SamuelHuet/DevBoard_STM32/Generated_files/EMS/NC Drill/PCB_carte_design-RoundHoles.TXT

M48
;Layer_Color=9474304
;FILE_FORMAT=4:2
METRIC,LZ
;TYPE=PLATED
T1F00S00C0.20
T2F00S00C0.25
T4F00S00C0.80
T5F00S00C0.89
T6F00S00C0.90
T8F00S00C1.00
T10F00S00C1.60
T12F00S00C2.00
%
T01
X0114Y010664
Y010774
X01151
Y010664
X01496Y011761
Y011871
X015071
Y011761
X013865Y014495
Y014605
Y014715
X013755
X013645
Y014605
X013755
Y014495
X013645
X012127Y013117
Y013017
Y012917
Y012817
X012027
X011927
Y012917
Y013017
X012027
Y012917
Y013117
X011927
T02
X00805Y00805
X0084
X00875
X0091
X00945
X0098
X01015
X0105
X01085
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
