SamuelHuet/DevBoard_STM32/Generated_files/BOM.xls

Sheet: BOM Report
Bill of Materials |  |  | Bill of Materials for Project [Carte_design.PrjPcb] (No PCB Document Selected)
Source Data From: |  | Carte_design.PrjPcb
Project: |  | Carte_design.PrjPcb
Variant: |  | None
Creation Date: | 12/12/2019 | 12:43
Print Date: | 2019-12-29 | 16:32:05
Production Quantity: | 1
Currency | EUR
Footprint | Comment | LibRef | Designator | Description | Quantity | Supplier | Supplier Part Number | Supplier Unit Price | Supplier Order Qty | Supplier Subtotal | Manufacturer | Manufacturer Part Number | Manufacturer Lifecycle
603 | 0F | Capa | C66, C67 |  | 2 | Farnell | 2447743 | 0.0043 | 10 | 0.05 | Multicomp | MCWR06X000 PTL | Unknown
603 | 0R | Resistance | R50, R63, R65 |  | 3 | Farnell | 2447743 | 0.0043 | 10 | 0.05 | Multicomp | MCWR06X000 PTL | Unknown
603 | 0.1µF | Capa | C11, C12, C15, C57, C59, C63, C64, C1, C2, C3, C4, C8, C9, C17, C23, C25, C27, C29, C30, C31, C32, C33, C54 |  | 23 | Farnell | 3013451 | 0.028 | 25 | 0.70 | Samsung | CL10F104ZO8NNNC | Unknown
603 | 1µF | Capa | C26, C43, C45, C58, C60, C62, C65, C72 |  | 8 | Farnell | 3013384 | 0.0468 | 10 | 0.47 | Samsung | CL10A105KO8NNNC | Unknown
603 | 1k | Resistance | R34 |  | 1 | Farnell | 2694685 | 0.0041 | 10 | 0.05 | Multicomp | MCWR06X102 JTL | Unknown
603 | 1nF | Capa | C24, C46, C47 |  | 3 | Farnell | 2581039 | 0.0533 | 10 | 0.54 | Kemet | C0603C102K4RACTU | Unknown
603 | 1.5k | Resistance | R5, R6, R16, R36, R51, R57, R64 |  | 7 | Farnell | 2694727 | 0.0049 | 10 | 0.05 | Multicomp | MCWR06X152 JTL | Unknown
603 | 13.7k | Resistance | R54 |  | 1 | Farnell | 2670631 | 0.0537 | 10 | 0.54 | Walsin | WR06X1372FTL | Unknown
603 | 2.2µF | Capa | C13, C14, C34, C35, C36, C37 |  | 6 | Farnell | 3013392 | 0.112 | 10 | 1.12 | Samsung | CL10A225KO8NNNC | Unknown
603 | 4.7µF | Capa | C42, C44, C73 |  | 3 | Farnell | 2525098 | 0.0197 | 4 | 0.08 | TDK | C1608X5R1C475M080AC | Unknown
603 | 4.7k | Resistance | R8, R9, R17, R18 |  | 4 | Farnell | 2694880 | 0.0047 | 10 | 0.05 | Multicomp | MCWR06X472 JTL | Unknown
603 | 6.49k | Resistance | R39 |  | 1 | Farnell | 2447426 | 0.0047 | 10 | 0.05 | Multicomp | MCWR06X6491FTL | Unknown
603 | 10k | Resistance | R1, R2, R31, R47, R59 |  | 5 | Farnell | 2447230 | 0.0043 | 10 | 0.05 | Multicomp | MCWR06X1002FTL | Unknown
603 | 10nF | Capa | C7, C16, C21, C22, C28, C61 |  | 6 | Farnell | 2534021 | 0.0429 | 10 | 0.43 | Wurth | 885012206040 | Unknown
603 | 10R | Resistance | R32, R33, R35, R37, R38, R40, R41, R42, R43, R44, R45, R46 |  | 12 | Farnell | 2447233 | 0.0044 | 15 | 0.07 | Multicomp | MCWR06X10R0FTL | Unknown
603 | 15pF | Capa | C70, C71 |  | 2 | Farnell | 2812095 | 0.0507 | 10 | 0.51 | Wurth | 885012006018 | Unknown
603 | 22µF | Capa | C10, C49, C50, C51 |  | 4 | Farnell | 2426957 | 0.282 | 10 | 2.82 | Murata | GRM188R61A226ME15D | Unknown
603 | 22pF | Capa | C5, C6, C18, C19, C38, C39, C40, C41, C68, C69 |  | 10 | Farnell | 2533830 | 0.0507 | 15 | 0.77 | Wurth | 885012006019 | Unknown
603 | 22R | Resistance | R11, R12, R14, R15, R19, R20, R21, R22, R23, R24, R25, R26, R27, R28, R29, R52, R53 |  | 17 | Farnell | 2694060 | 0.0087 | 20 | 0.18 | Multicomp | MCWF06P22R0FTL | Unknown
603 | 100k | Resistance | R3, R4, R7, R49, R56, R58, R60, R61, R62, R66 |  | 10 | Farnell | 2333579 | 0.0105 | 15 | 0.16 | Bourns | CR0603-JW-104ELF | Unknown
603 | 100pF | Capa | C56 |  | 1 | Farnell | 2812335 | 0.0436 | 10 | 0.44 | Wurth | 885012206028 | Unknown
603 | 100R | Resistance | R10, R13, R30, R55 |  | 4 | Farnell | 2447227 | 0.0049 | 10 | 0.05 | Multicomp | MCWR06X1000FTL | Unknown
603 | 150nF | Capa | C55 |  | 1 | Farnell | 1759018 | 0.0533 | 10 | 0.54 | Multicomp | MC0603F154Z160CT | Unknown
603 | 220R | Resistance | R48 |  | 1 | Farnell | 2447298 | 0.0049 | 10 | 0.05 | Multicomp | MCWR06X2200FTL | Unknown
402 | 3.9nH | self2 | L3 |  | 1 | Digi-Key | 490-15282-1-ND | 0.14 | 1 | 0.14 | Murata | LQG15WZ3N9S02D | Unknown
603 | 10µF | Capa | C48, C52, C53 |  | 3 | Farnell | 2611923 | 0.335 | 10 | 3.35 | Murata | GRM188R61C106KAALD | Unknown
Capa_Radial_D4mm_H5.5mm, 0603 | 10µF | Capa_pola | C20 |  | 1 | Farnell | 2466357 | 0.237 | 1 | 0.24 | Wurth Electronics | 865090240001 | Volume Production
603 | 2nH | Self | L4 |  | 1 | Digi-Key | 490-5981-1-ND | 0.24 | 1 | 0.24 | Murata | BLM18GG471SN1D | Volume Production
4-UFBGA | BALF-NRG-02D3 | Balf | U11 |  | 1 | Digi-Key | 497-17591-1-ND | 0.28 | 2 | 0.56 | STMicroelectronics | BALF-NRG-02D3 | Unknown
Mini_USB_mixte | 10118193-0001LF | 10118193-0001LF | J1, J4 | CONN RCPT USB2.0 MICRO B SMD R/A | 2 | Digi-Key | 609-4616-1-ND | 0.39 | 2 | 0.78 | Amphenol ICC | 10118193-0001LF | Unknown
LEd_Pilou | RFN2LAM4STFTR | RFN2LAM4STFTR | D5, D6, D7 | RFN2LAM4STF IS THE HIGH RELIABIL | 3 | Mouser | 755-RFN2LAM4STFTR | 0.414 | 3 | 1.25 | Rohm | RFN2LAM4STFTR | Unknown
QFN50P300X300X65_HS-17M | PI5C3257ZHDEX | PI5C3257ZHDEX | U1 | Multiplexer/Demultiplexer Bus Switch 4-Channel 2: 1 16-Pin UQFN T/R | 1 | Digi-Key | PI5C3257ZHDEXDICT-ND | 0.53 | 1 | 0.53 | Diodes | PI5C3257ZHDEX | Unknown
PSON65P300X100_HS-9M | MCP1727-3302E/MF | LDO | U8 |  | 1 | Farnell | 1851978 | 0.756 | 1 | 0.76 | Microchip | MCP1727-3302E/MF | Volume Production
PSON65P300X100_HS-9M | MCP1727-ADJE/MF | LDO | U7 |  | 1 | Farnell | 1851979 | 0.756 | 1 | 0.76 | Microchip | MCP1727-ADJE/MF | Volume Production
 | 8MHz | Quartz_8MHz | Q1 |  | 1 | Farnell | 1611803 | 0.698 | 1 | 0.70 | Abracon | ABMM2-8.000MHZ-E2-T | Volume Production
Quartz_prog, Quartz_Micro_HF | 8MHz | Quartz_micro_HF | Q4 |  | 1 | Farnell | 2854010 | 0.6 | 1 | 0.60 | Multicomp | MCSJK-7I-8.00-10-10-60-B-10 | Unknown
QFN50P400X400X90_HS-25M | KSZ8081RNACA | KSZ8081RNACA | U4 | IC TXRX ETHERNET 24QFN | 1 | Farnell | 2809920 | 0.891 | 1 | 0.90 | Microchip | KSZ8081RNACA | Volume Production
BLE_Quartz_Sxtal | 32KHz | BLE_quartz_Sxtal | Q3, Q5 |  | 2 | Digi-Key | 644-1219-1-ND | 0.82 | 2 | 1.64 | NDK | NX2012SA-32.768K-STD-MUB-1 | Volume Production
BLE_Quartz_Fxtal | 32MHz | BLE_Quartz_Fxtal | Q6 |  | 1 | Digi-Key | 1253-1118-1-ND | 0.85 | 1 | 0.85 | Kyocera AVX | CX2016DB32000D0FLJCC | Volume Production
Switch_slider | microswitch | microswitch | S1 |  | 1 | Farnell | 2854716 | 0.955 | 1 | 0.96 | Nidec Copal | CAS-120TA | Volume Production
Header_prog | Header 2.54mm | Header_prog | J6 |  | 1 | Farnell | 3049397 | 1.13 | 1 | 1.13 | Molex | 90131-0126 | Volume Production
UFL | UFL | UFL | ANT1 |  | 1 | Mouser | 798-UFLRSMT140 | 1.03 | 1 | 1.03 | Hirose | U.FL-R-SMT-1(40) | Volume Production
Oscillateur | 24MHz | Oscillateur | X1 |  | 1 | Mouser | 581-KC2520B24.0C10 | 1.21 | 1 | 1.21 | Kyocera | KC2520B24.0000C10E00 | Unknown
Header_2.54_2rang | OV7670 | OV7670 | J2 |  | 1 | Farnell | 1804359 | 1.99 | 1 | 1.99 | Samtec | SSW-109-02-T-D-RA | Unknown
BP | BP | BP | BP1 |  | 1 | Farnell | 1217752 | 1.74 | 1 | 1.74 | Schurter | 1241.1600.11 | Volume Production
self_alim | 1.5µH | self_alim | L1 |  | 1 | Mouser | 994-XFL4020-152MEB | 2.07 | 1 | 2.07 | Coilcraft | XFL4020-152MEB | Volume Production
Jack | DC Jack | Jack | J5 |  | 1 | Farnell | 2520583 | 2.21 | 1 | 2.21 | Cliff | FC681465S | Unknown
SON127P800X80_HS-9M | W25N01GVZEIT | W25N01GVZEIT | U5 |  | 1 | Mouser | 454-W25N01GVZEIT | 2.19 | 1 | 2.19 | Winbond | W25N01GVZEIT | Unknown
BuckBoost | TPS63070 | 12-5V_BuckBoost | U9 |  | 1 | Mouser | 595-TPS630701RNMR | 2.33 | 1 | 2.33 | Texas Instruments | TPS630701RNMR | Unknown
QFN50P500X500X100_HS-33M | BLUENRG-232 | BLUENRG-232 | U10 |  | 1 | Farnell | 2771347 | 3.41 | 1 | 3.41 | STMicroelectronics | BLUENRG-232 | Unknown
CQFP50P900X900X160-48M | STM32F103C8T6 | STM32F103C8T6 | U2 |  | 1 | Farnell | 1447637 | 6.01 | 1 | 6.01 | STMicroelectronics | STM32F103C8T6 | Volume Production
RJ45 | RJ45 - 74990101212 | RJ45 | J3 |  | 1 | Mouser | 710-74990101212 | 5.94 | 1 | 5.94 | Wurth Electronics | 74990101212 | Unknown
LQFP100_14x14_0.5pitch | STM32H750BTV6 | STM32H750BTV6 | U12 |  | 1 | Farnell | 2980947 | 7.35 | 1 | 7.35 | STMicroelectronics | STM32H750VBT6 | Unknown
SOD123 | 1N4148 | 1N4148 | D2, D3 |  | 2 | Farnell | 1776392 | 0.163 | 5 | 0.82 | Diodes | 1N4148W-7-F | Volume Production
SMD_3225 | 25MHz | Quartz_25MHz | Q2 |  | 1 | Farnell | 2853968 | 0.211 | 5 | 1.06 | Multicomp | MCSJK-7U-25.00-12-10-60-B-10 | Unknown
GPIO_header | Bornier_2.54mm | GPIO_bornier | J7 |  | 1 | Farnell | 1593464 | 0.235 | 5 | 1.18 | Multicomp | 2212S-10SG-85 | Volume Production
LED_0603 | Led | Led | D1, D4 |  | 2 | Farnell | 2687486 | 0.235 | 5 | 1.18 | Rohm | SML-D12P8WT86C | Unknown
SOT95P280X145-6M | USBLC6-2P6 | USBLC6-2P6 | U3, U6 | TVS DIODE 5.25V 17V SOT666 | 2 | Farnell | 1295310 | 0.458 | 5 | 2.29 | STMicroelectronics | USBLC6-2P6 | Volume Production
0805_W1.25 | Ferrite | Ferrite | F1 |  | 1 | Farnell | 2443252 | 0.0631 | 10 | 0.64 | Murata | BLM21PG121SN1D | Volume Production
603 | 10µH | Self | L2 |  | 1 | Farnell | 2285917 | 1.16 | 5 | 5.80 | Coilcraft | 0603AF-103XJRU | Unknown
MIKROBUS HOST CONN. | MIKROBUS HOST CONN. | MIKROBUS HOST CONN._1 | MIKROBUS 1 | mikroBUS Host Socket | 1 | Farnell | 1593463 | 0.183 | 10 | 1.83 | Multicomp | 2212S-08SG-85 | Volume Production
 |  |  |  |  | 181 |  |  |  |  | 77.49 €
Approved |  | Notes

Sheet: Project Information
Project Full Path | C:\Users\Cocasticox\Desktop\Carte_design1\Carte_design.PrjPcb
Project Filename | Carte_design.PrjPcb
Variant Name | None
Data-Source Filename | Carte_design.PrjPcb
Data-Source Full Path | C:\Users\Cocasticox\Desktop\Carte_design1\Carte_design.PrjPcb
Title | Bill of Materials for Project [Carte_design.PrjPcb] (No PCB Document Selected)
Total Quantity | 181
Report Time | 12:43
Report Date | 12/12/2019
Report Date & Tine | 12/12/2019 12:43
Output Name | Bill of Materials
Output Type | BOM_PartType
Output Generator Name | BOM
Output Generator Description | Bill of Materials
