SamuelHuet/DevBoard_STM32/Altium/3D/User Library-CSPG.STEP

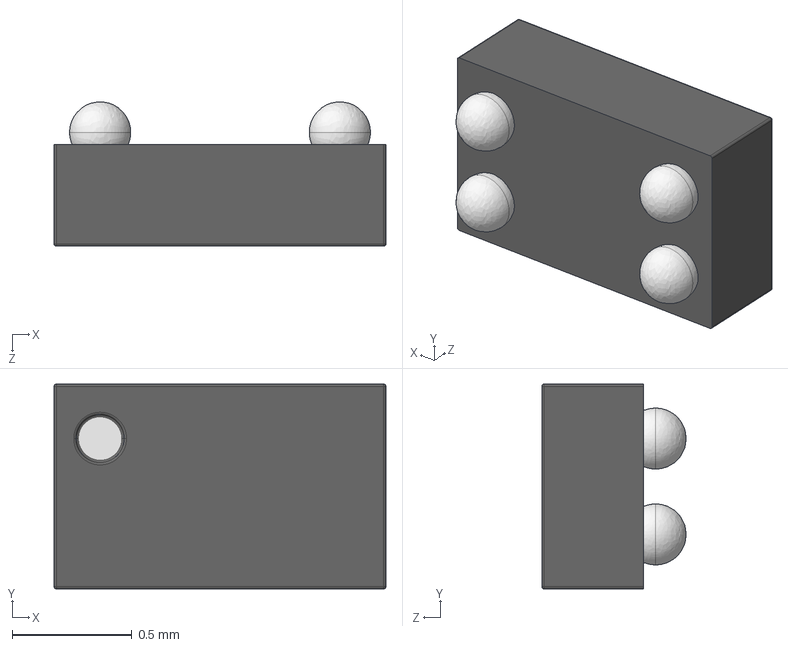
[picture p43: CAD file, 2020-01-07]
Altium/3D/User Library-CSPG.STEP
1.38 x 0.855 x 0.603 mm
