SamuelHuet/DevBoard_STM32/Altium/3D/c-1-2301994-3-a-3d.stp

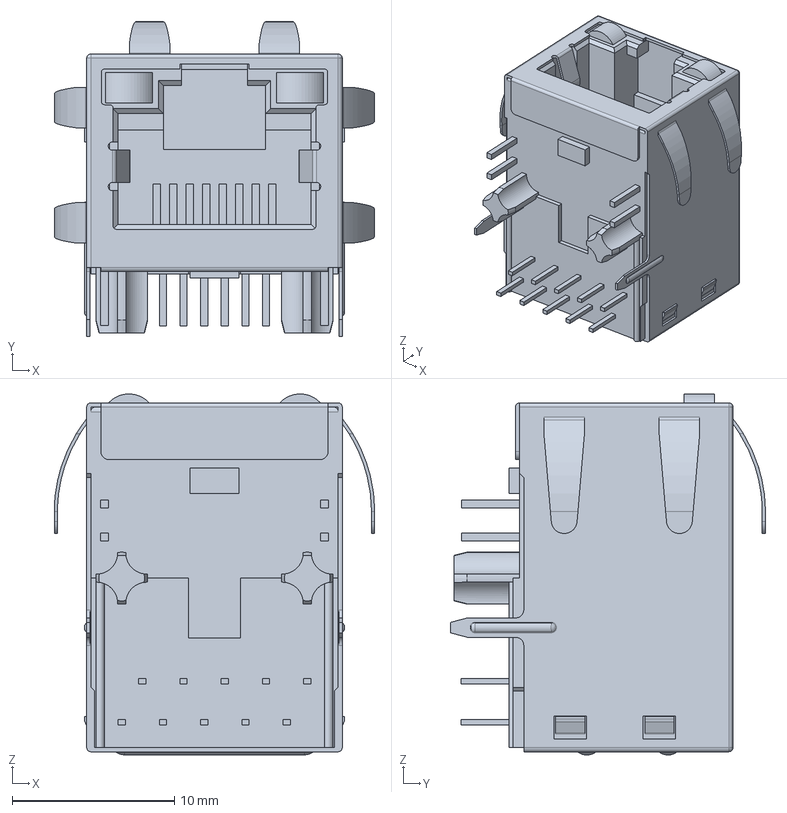
[picture p44: CAD file, 2020-01-07]
Altium/3D/c-1-2301994-3-a-3d.stp
19.8 x 19.4 x 22.2 mm
