SamuelHuet/DevBoard_STM32/Altium/3D/User Library-ABMM2.STEP

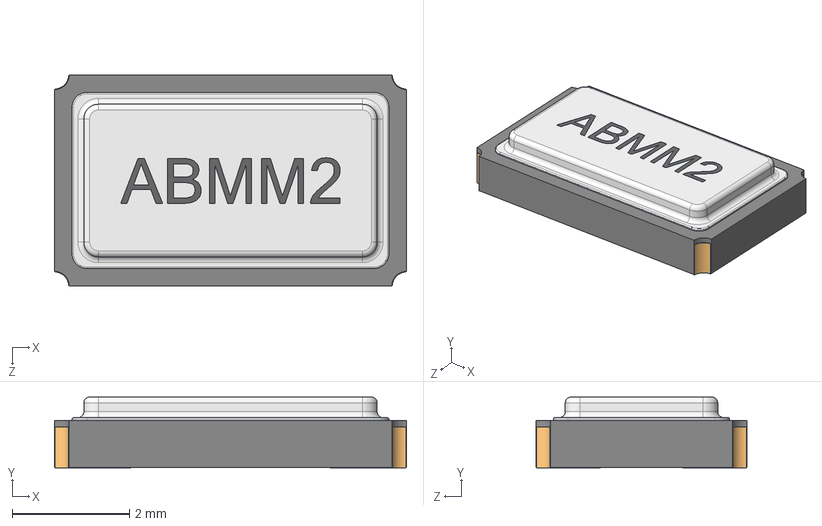
[picture p45: CAD file, 2020-01-07]
Altium/3D/User Library-ABMM2.STEP
6.00 x 1.21 x 3.60 mm
K_X_F6rper 1_1
K_X_F6rper 2_1
Beschriftung_1
PINS_1
