SamuelHuet/DevBoard_STM32/Altium/3D/93f5544_280373-2.stp

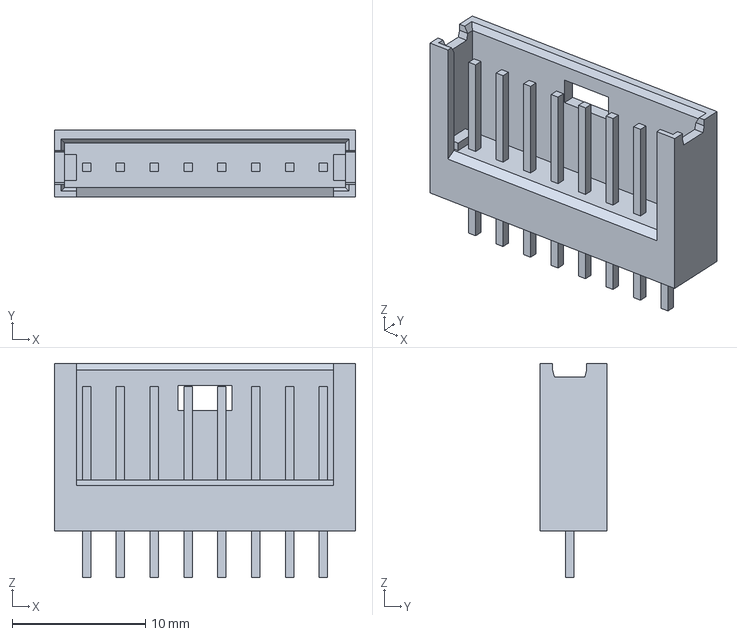
[picture p46: CAD file, 2020-01-07]
Altium/3D/93f5544_280373-2.stp
22.6 x 5.00 x 16.1 mm
