SamuelHuet/DevBoard_STM32/Altium/3D/User Library-H53-5x3_2.step

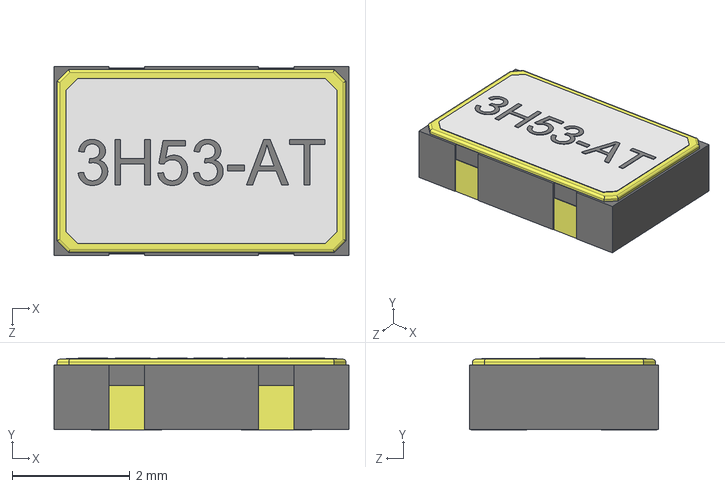
[picture p47: CAD file, 2020-01-07]
Altium/3D/User Library-H53-5x3_2.step
5.00 x 1.22 x 3.20 mm
