SamuelHuet/DevBoard_STM32/Altium/3D/User Library-LED SMD0603.step

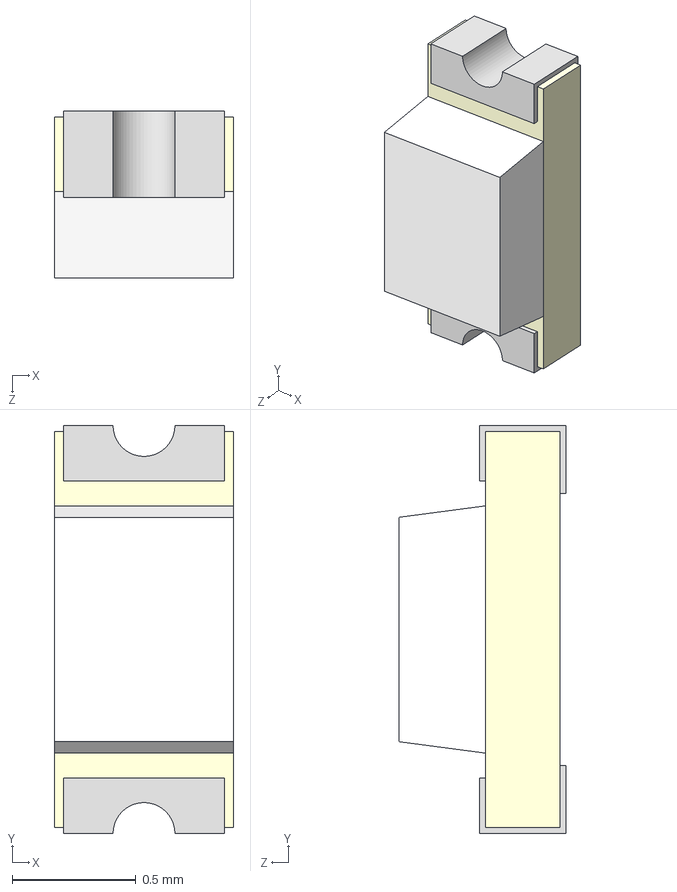
[picture p48: CAD file, 2020-01-07]
Altium/3D/User Library-LED SMD0603.step
0.725 x 1.65 x 0.675 mm
