SamuelHuet/DevBoard_STM32/Altium/3D/User Library-CX2016DB16000D0GPSC1.STEP

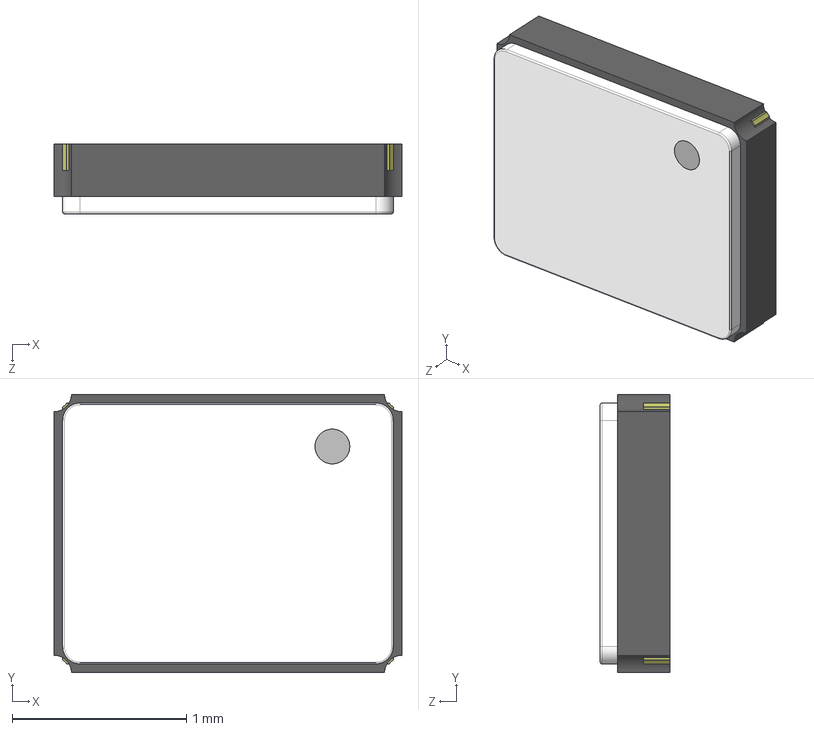
[picture p50: CAD file, 2020-01-07]
Altium/3D/User Library-CX2016DB16000D0GPSC1.STEP
2.00 x 1.60 x 0.4 mm
ACIS Solid_1923
ACIS Solid_1935
