SamuelHuet/DevBoard_STM32/Altium/3D/User Library-sop8_model.STEP

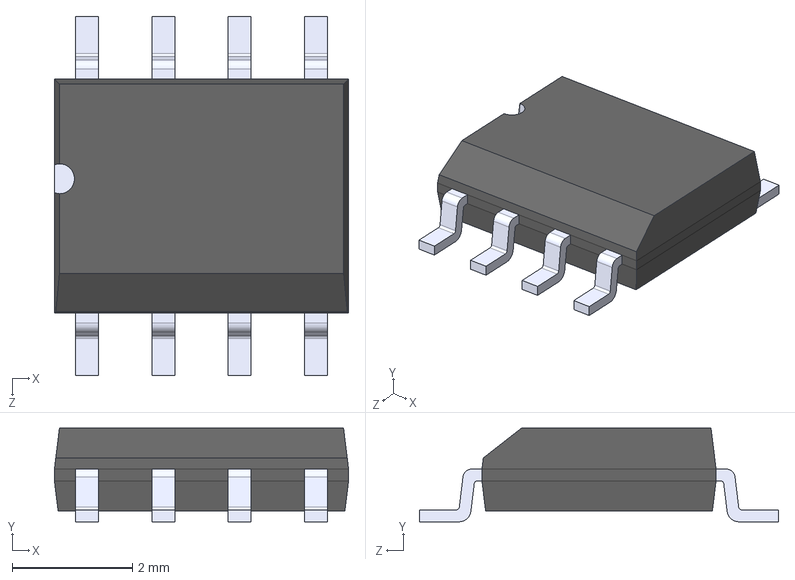
[picture p51: CAD file, 2020-01-07]
Altium/3D/User Library-sop8_model.STEP
4.90 x 1.56 x 5.98 mm
pin5to8_sop8 x 8
sop8_body
