SamuelHuet/DevBoard_STM32/Altium/3D/TPD6E001RSER--3DModel-STEP-56544.STEP

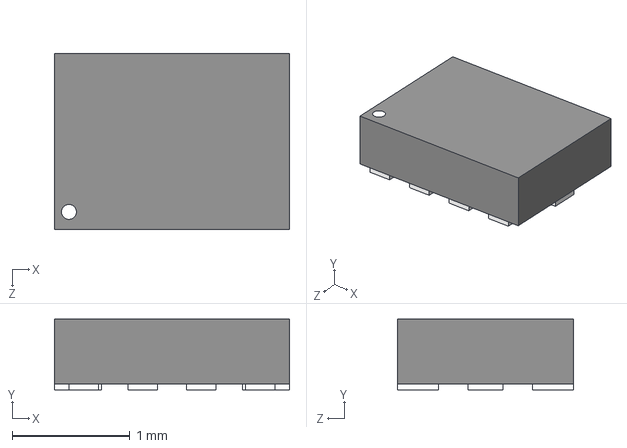
[picture p52: CAD file, 2020-01-07]
Altium/3D/TPD6E001RSER--3DModel-STEP-56544.STEP
2.00 x 0.6 x 1.50 mm
