SamuelHuet/DevBoard_STM32/Altium/3D/cga0402mlc-05g.stp

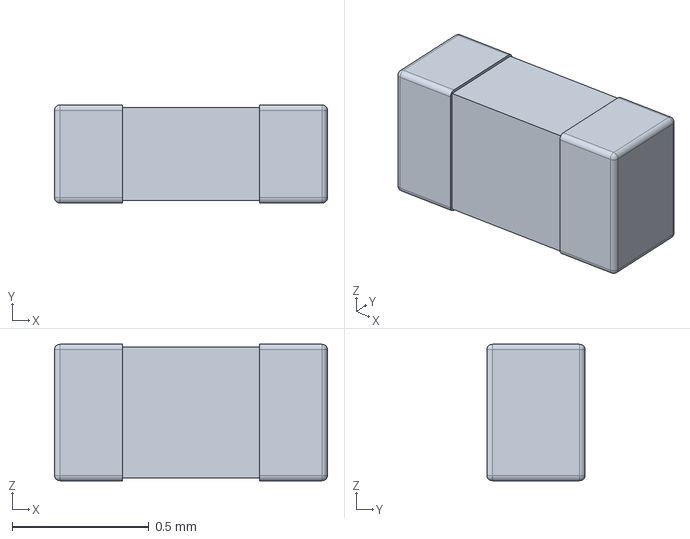
[picture p53: CAD file, 2020-01-07]
Altium/3D/cga0402mlc-05g.stp
1.00 x 0.36 x 0.5 mm
