SamuelHuet/DevBoard_STM32/Altium/3D/User Library-DPAK-5.step

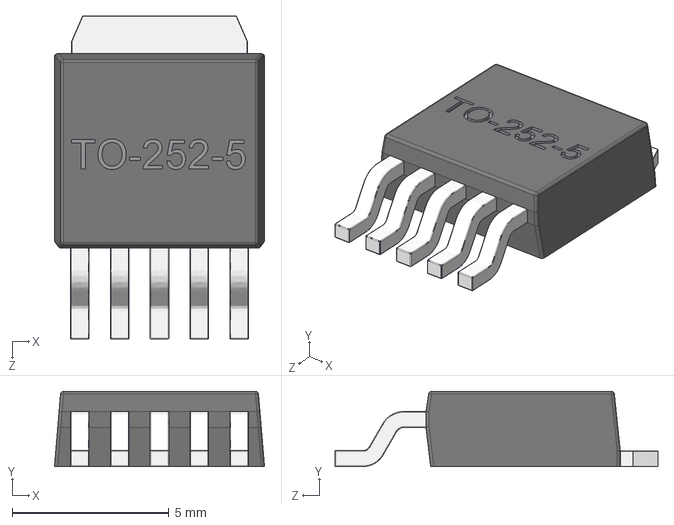
[picture p54: CAD file, 2020-01-07]
Altium/3D/User Library-DPAK-5.step
6.70 x 2.40 x 10.3 mm
