SamuelHuet/DevBoard_STM32/Altium/3D/User Library-User Library-Siward_SX3225.step

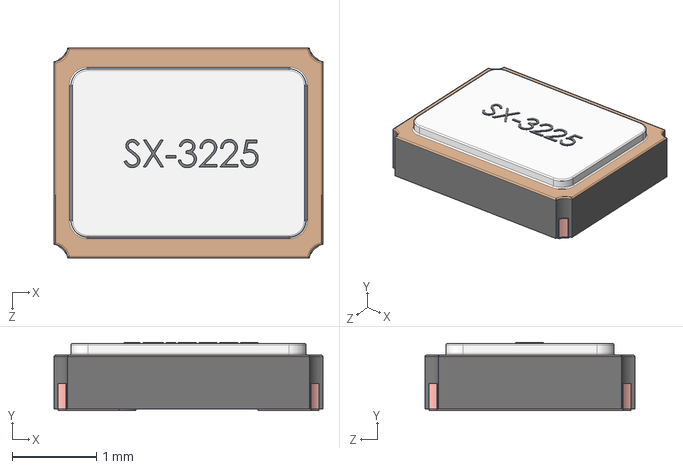
[picture p55: CAD file, 2020-01-07]
Altium/3D/User Library-User Library-Siward_SX3225.step
3.20 x 0.81 x 2.50 mm
