SamuelHuet/DevBoard_STM32/Altium/3D/7A-24.000MAAJ-T--3DModel-STEP-56544.STEP

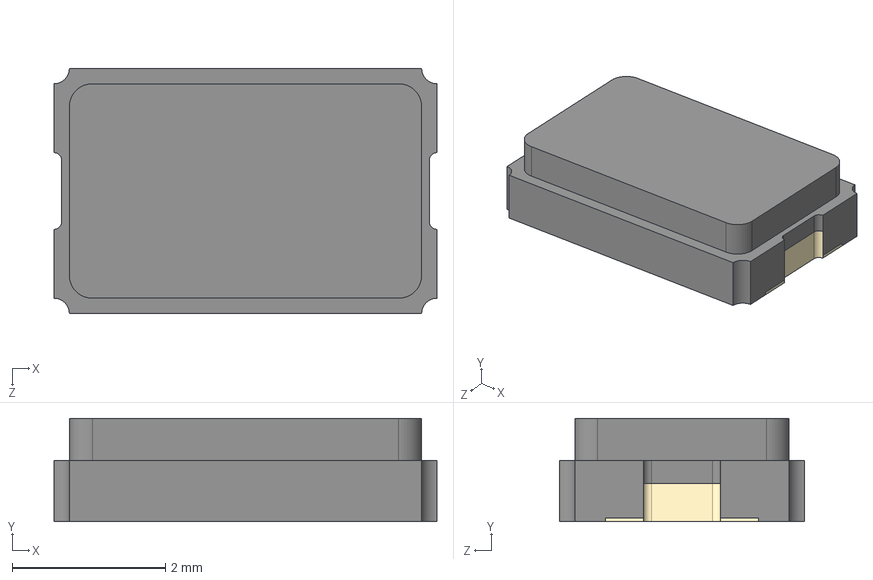
[picture p56: CAD file, 2020-01-07]
Altium/3D/7A-24.000MAAJ-T--3DModel-STEP-56544.STEP
5.00 x 1.35 x 3.20 mm
