SamuelHuet/DevBoard_STM32/Altium/3D/pcb_connector_801-87-008-66-001101.stp

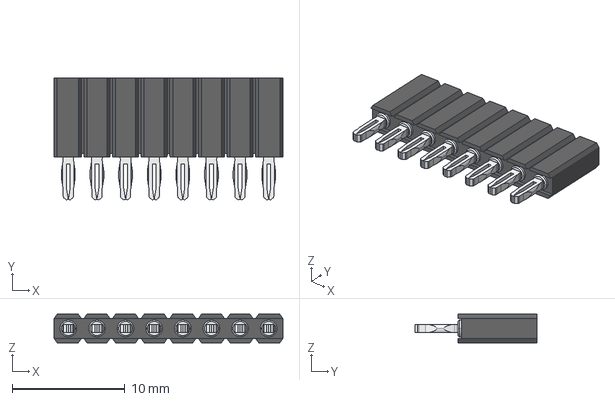
[picture p57: CAD file, 2020-01-07]
Altium/3D/pcb_connector_801-87-008-66-001101.stp
20.3 x 10.8 x 2.54 mm
