SamuelHuet/DevBoard_STM32/Altium/3D/User Library-SOD123-1.step

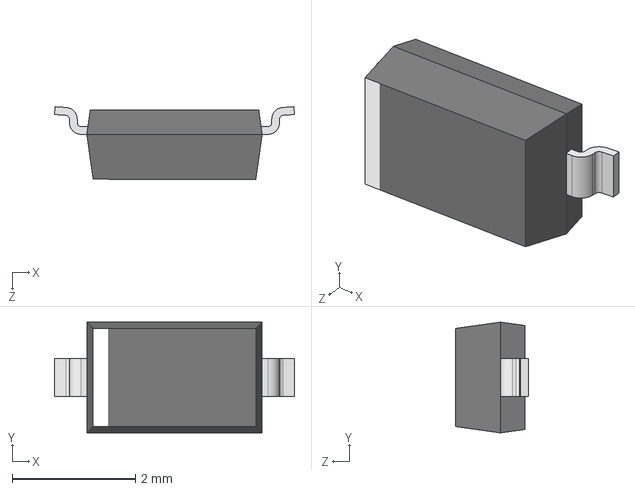
[picture p58: CAD file, 2020-01-07]
Altium/3D/User Library-SOD123-1.step
3.90 x 1.80 x 1.18 mm
