SamuelHuet/DevBoard_STM32/Altium/3D/CircuitWorks-RESISTOR 0603.step

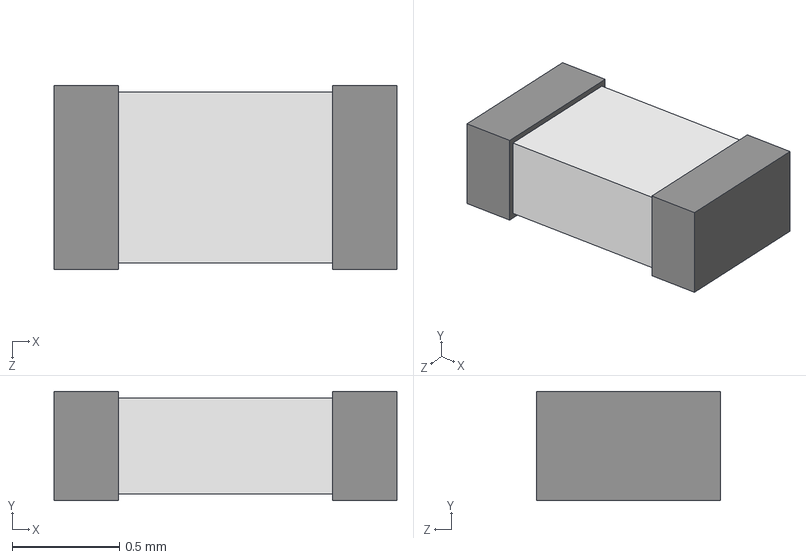
[picture p59: CAD file, 2020-01-07]
Altium/3D/CircuitWorks-RESISTOR 0603.step
1.60 x 0.51 x 0.86 mm
