SamuelHuet/DevBoard_STM32/Altium/3D/female_header_a-bl254-da-g18d.stp

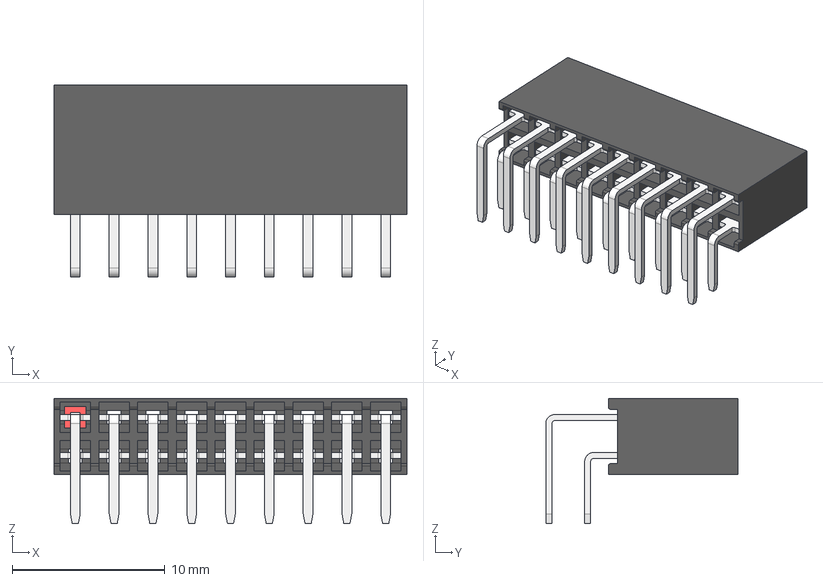
[picture p60: CAD file, 2020-01-07]
Altium/3D/female_header_a-bl254-da-g18d.stp
23.1 x 12.6 x 8.20 mm
