SamuelHuet/DevBoard_STM32/Altium/3D/User Library-CAPSMD4x5_5.STEP

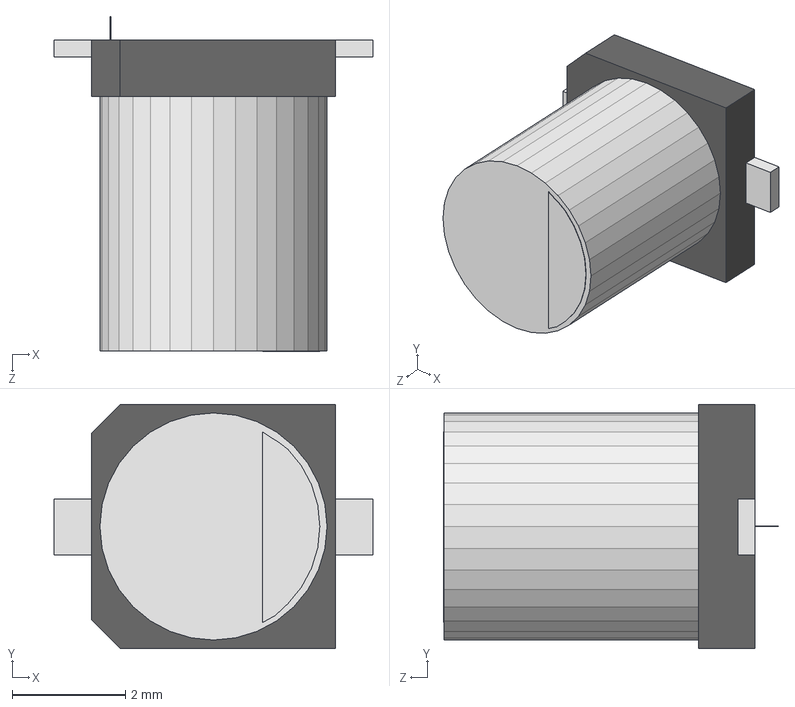
[picture p61: CAD file, 2020-01-07]
Altium/3D/User Library-CAPSMD4x5_5.STEP
5.64 x 4.32 x 5.93 mm
Extruded3
Extruded2 x 2
Extruded1
Extruded
Board
