SamuelHuet/DevBoard_STM32/(list of files, cad)

Other CAD files:
Altium/3D/ESW-104-33-H-D.dwg
Altium/3D/10118193-0001LF--3DModel-STEP-56544.STEP
Altium/3D/1206003_281739-6.stp
Altium/3D/27820.stp
Altium/3D/7731311812lf.stp
