SamuelHuet/DevBoard_STM32/Generated_files/Schematique.pdf

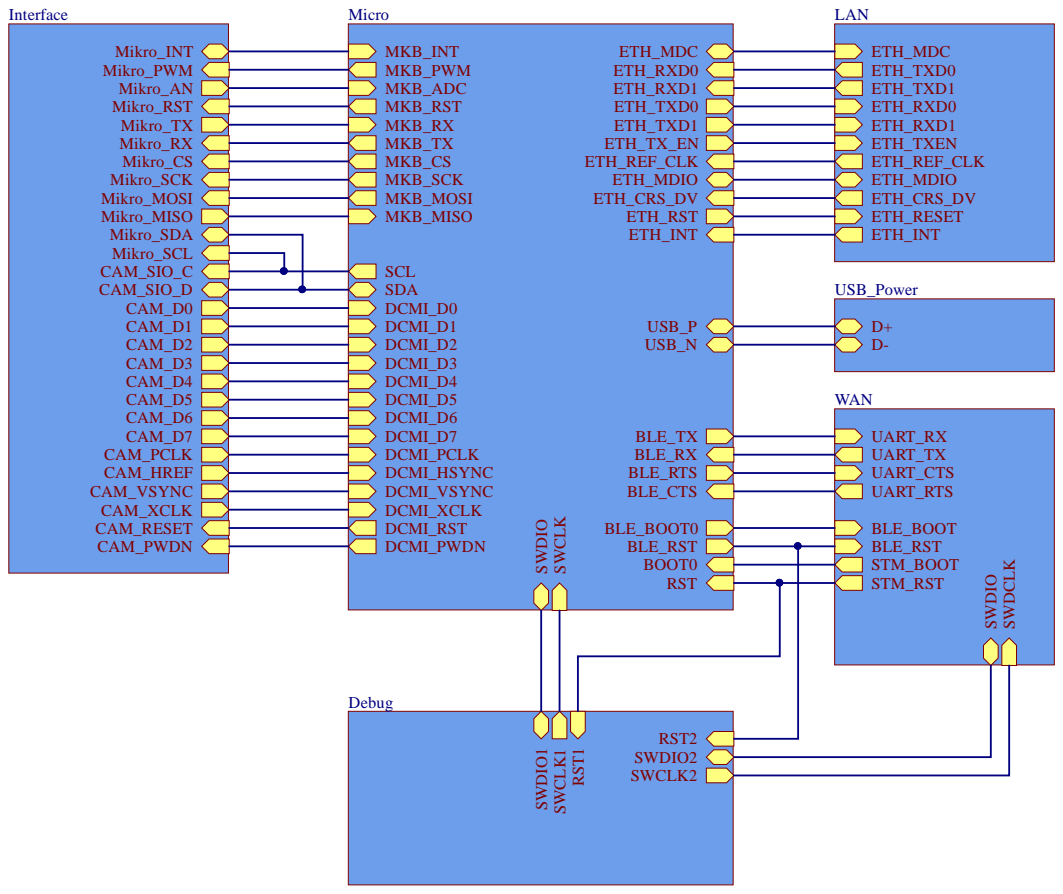
[picture p62: page 1]

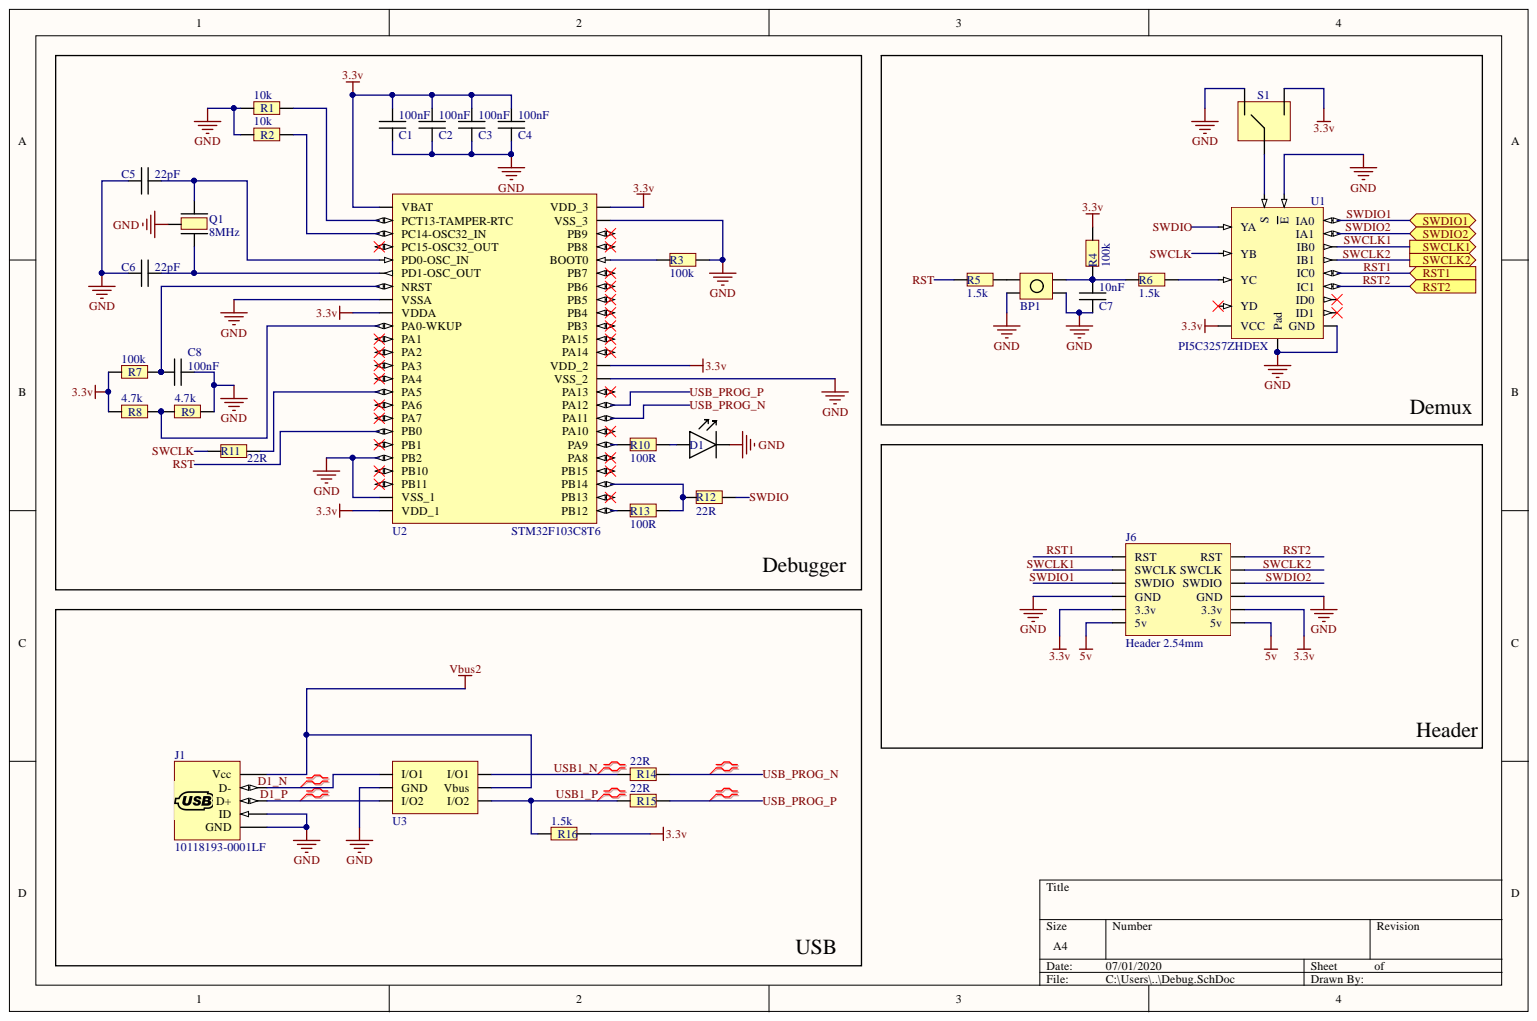
[picture p63: page 2]

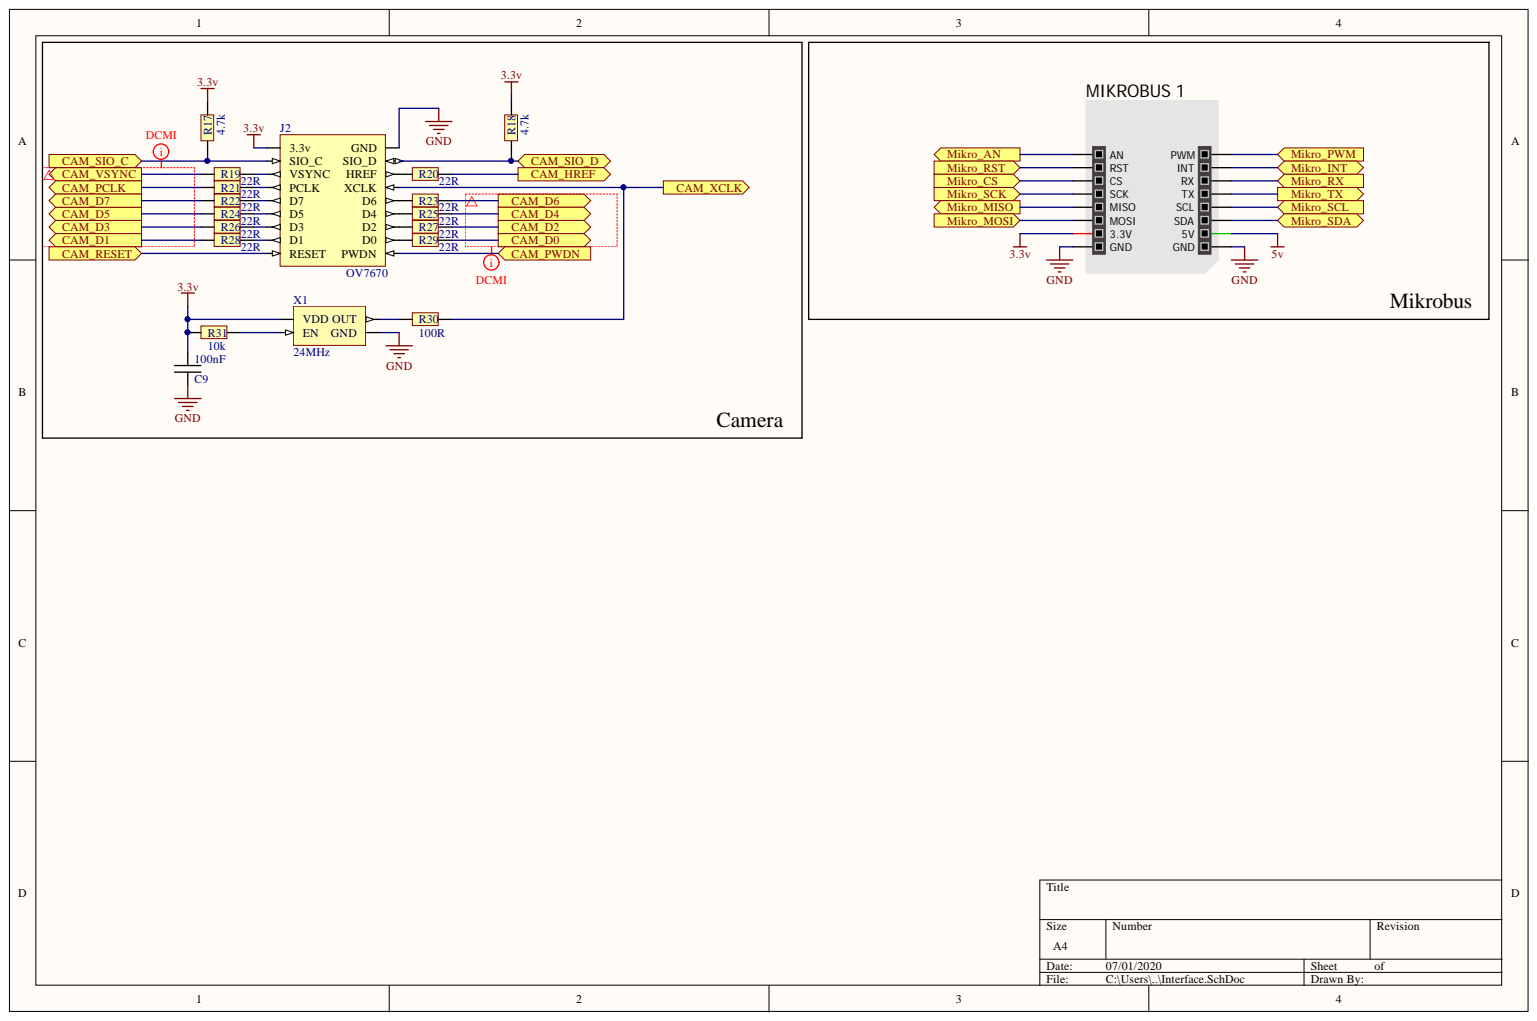
[picture p64: page 3]

ANRST
SCK MISO MOSI 3.3V GND

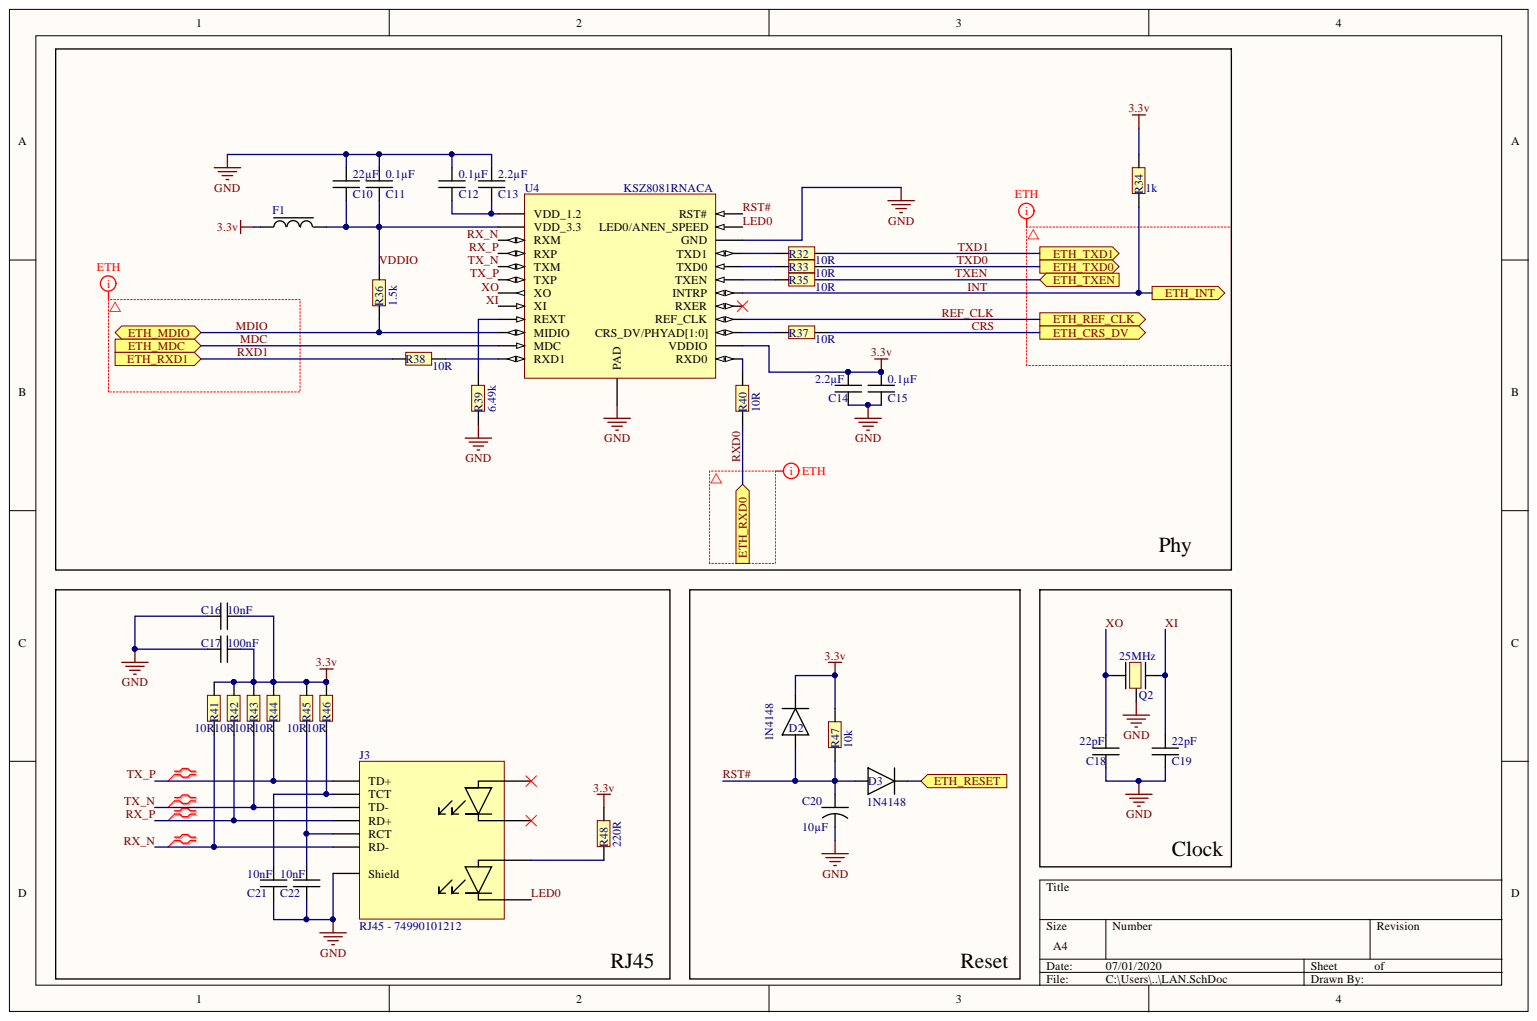
[picture p65: page 4]

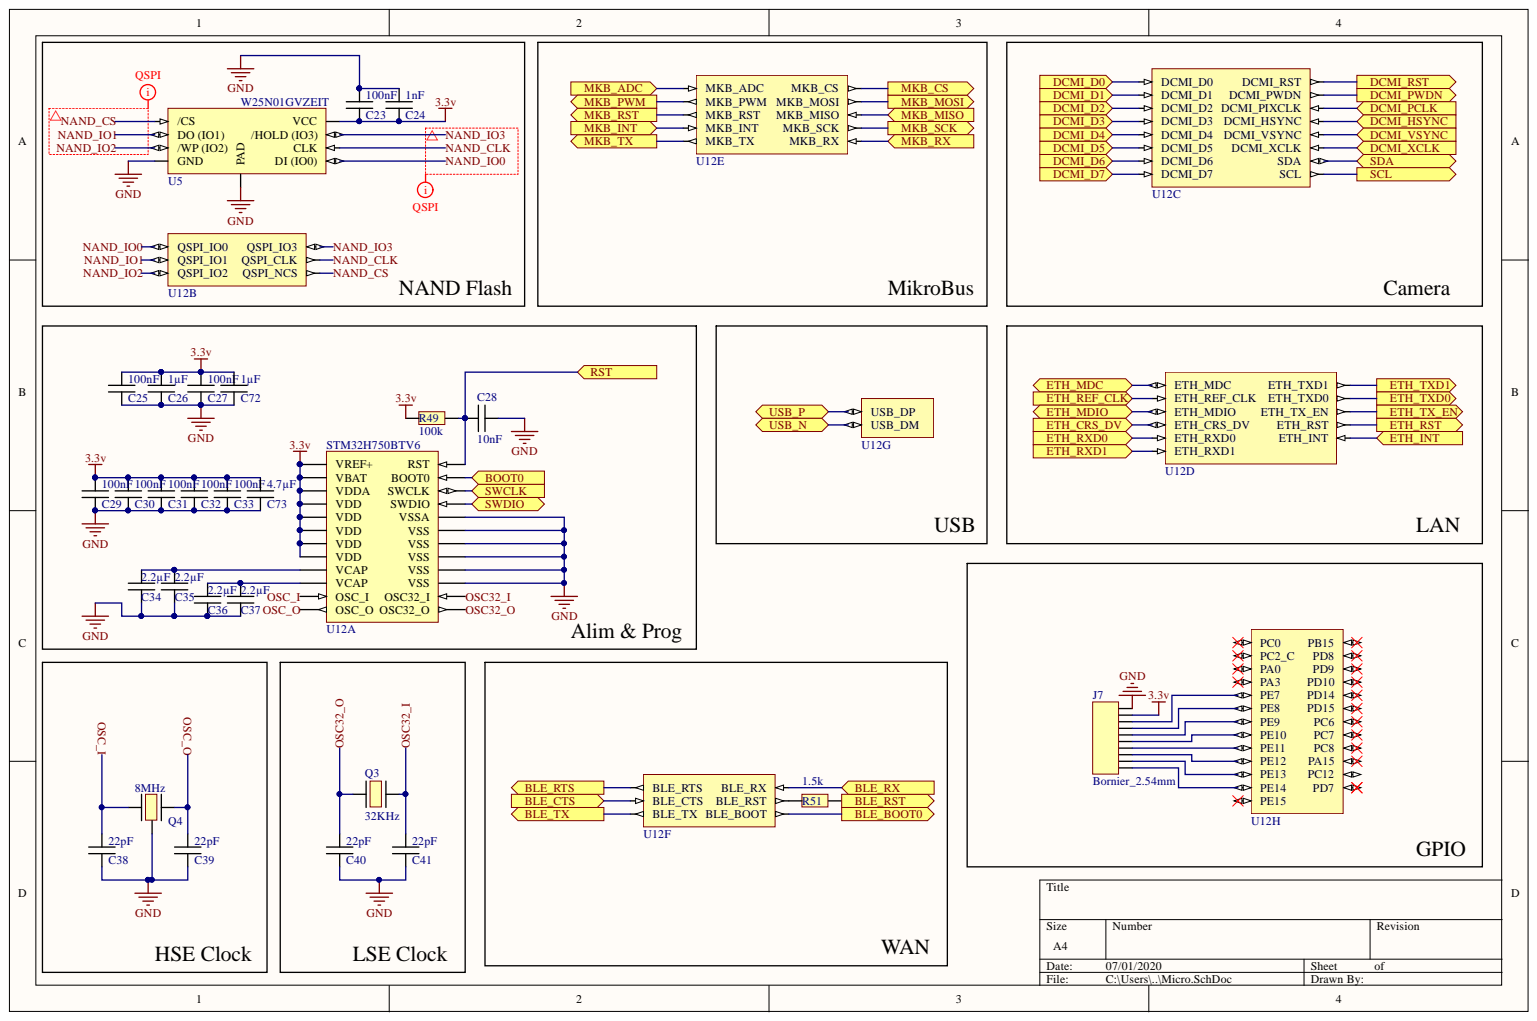
[picture p66: page 5]

GPIO

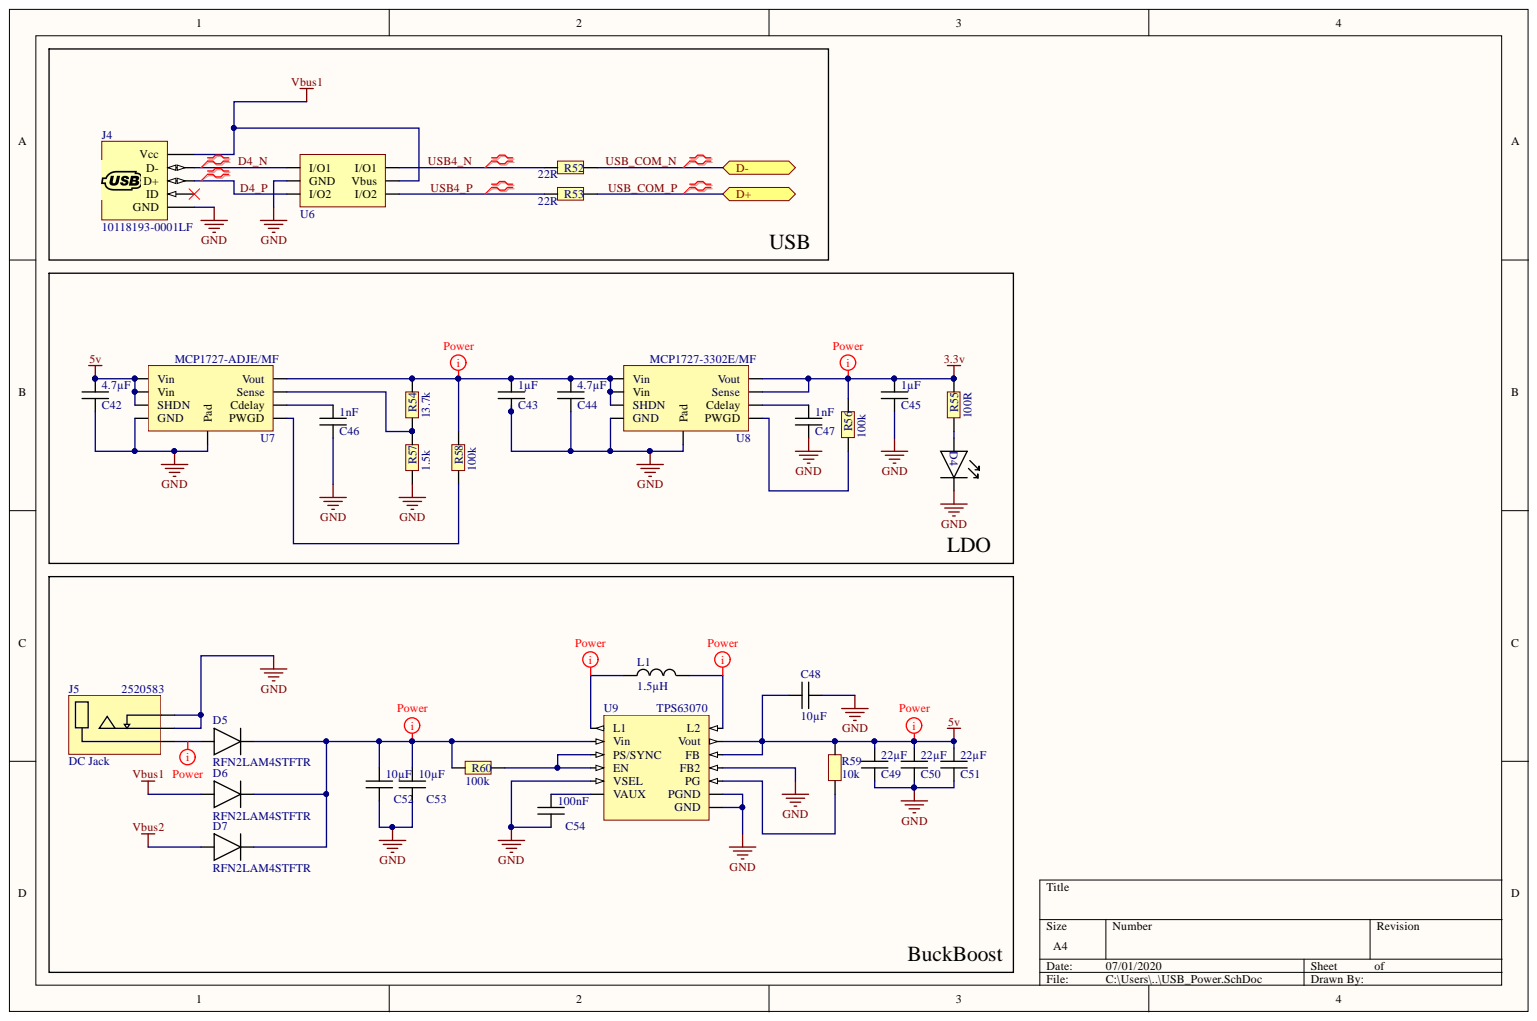
[picture p67: page 6]

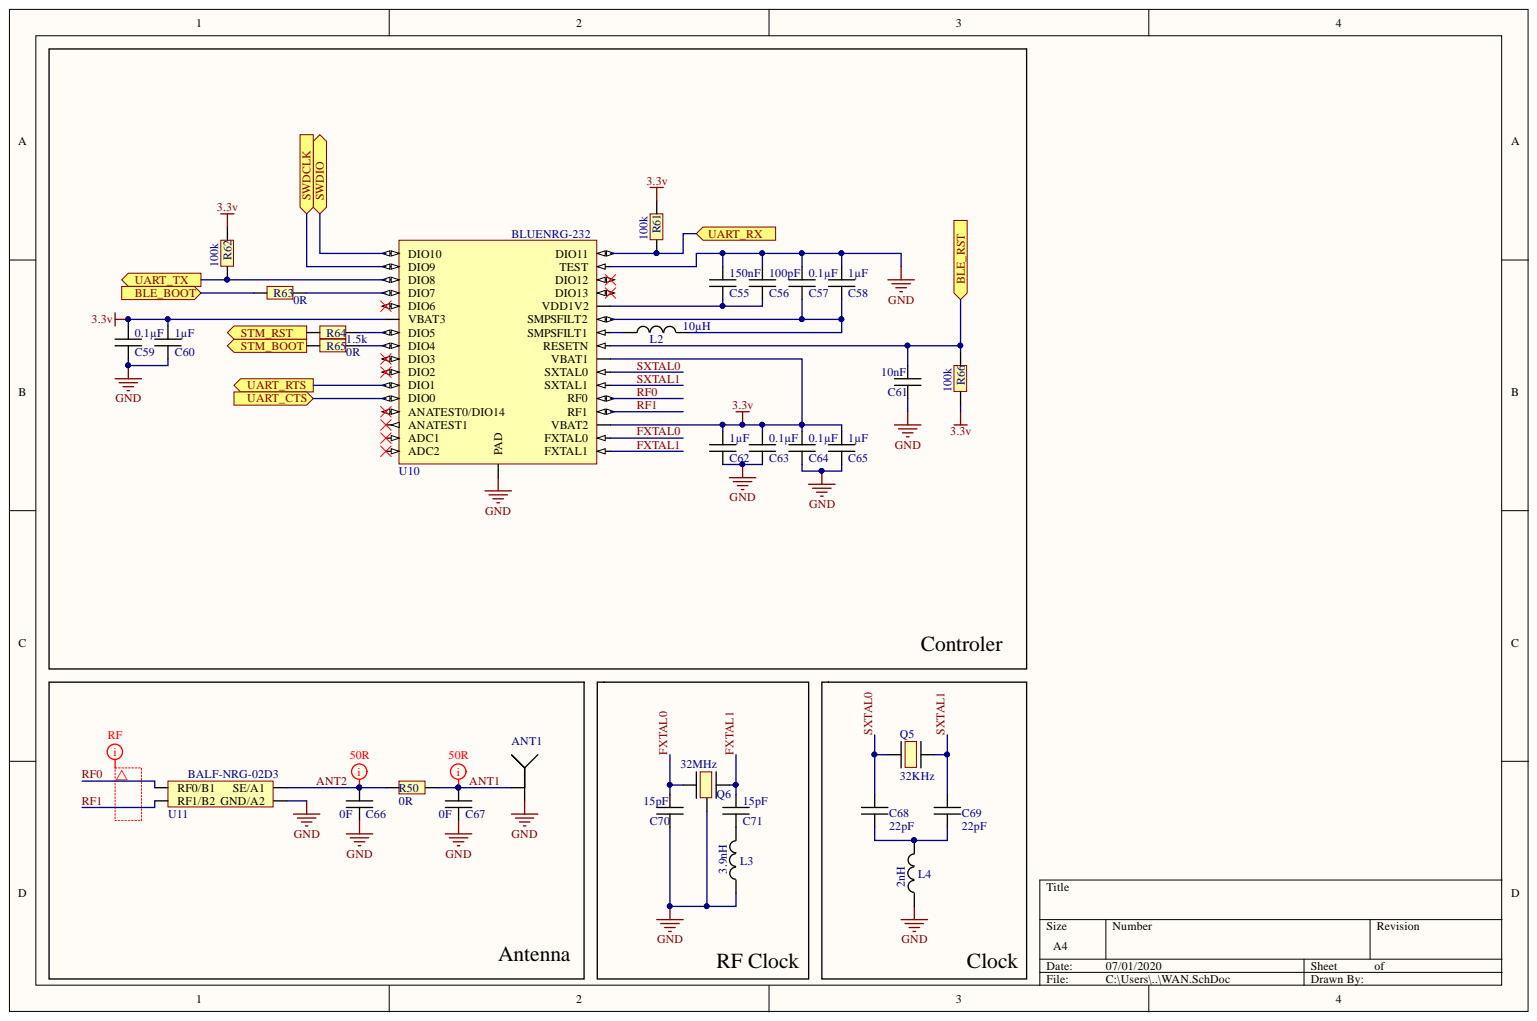
[picture p68: page 7]
