SamuelHuet/DevBoard_STM32/(list of files, drawings)

Other design files:
Altium/Carte_design.PrjPcb
Altium/Carte_design_PCBLib.PcbLib
Altium/Carte_design_SCH.SchDoc
Altium/Carte_design_SCHLib.SchLib
Altium/Debug.SchDoc
Altium/Interface.SchDoc
Altium/LAN.SchDoc
Altium/Micro.SchDoc
Altium/mikrobus-socket-pcb-specification/mikroBUS_Add-on_board_standard/mikroBUS_Add-on_standard.PcbLib
Altium/mikrobus-socket-pcb-specification/mikroBUS_Add-on_board_standard/mikroBUS_Add-on_standard.SchLib
Altium/mikrobus-socket-pcb-specification/mikroBUS_socket_standard/mikroBUS_socket_standard.PcbLib
Altium/mikrobus-socket-pcb-specification/mikroBUS_socket_standard/mikroBUS_socket_standard.SchLib
Altium/USB_Power.SchDoc
Altium/WAN.SchDoc
